Hongyuan-mees/embedded-game/MotionGolf_Stage1_v4/README.md

* WASD / 方向键由 KEYDOWN + KEYUP 自己维护状态
* 主动关闭文本输入 / IME 模式
* Pause / Restart 有鼠标按钮
* F1 = Pause / Resume
* F2 = Restart
* P / R 仍保留，但不是必须使用
* 窗口失去焦点时自动清空按键状态，防止“卡键”
* 右侧 Last event 可以确认事件系统是否正常
