Hongyuan-mees/embedded-game/motion-controller/Core\Src\stm32f1xx_hal_msp.c

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
/* Includes ------------------------------------------------------------------*/
#include "main.h"
/* External functions --------------------------------------------------------*/
/**
  * Initializes the Global MSP.
  */
void HAL_MspInit(void)
{

  __HAL_RCC_AFIO_CLK_ENABLE();
  __HAL_RCC_PWR_CLK_ENABLE();

  /* System interrupt init*/

  /** NOJTAG: JTAG-DP Disabled and SW-DP Enabled
  */
  __HAL_AFIO_REMAP_SWJ_NOJTAG();

}

/* USER CODE BEGIN 1 */

void HAL_I2C_MspInit(I2C_HandleTypeDef *hi2c)
{
  GPIO_InitTypeDef GPIO_InitStruct = {0};

  if (hi2c->Instance == I2C1)
  {
    __HAL_RCC_GPIOB_CLK_ENABLE();
    __HAL_RCC_I2C1_CLK_ENABLE();
    __HAL_AFIO_REMAP_I2C1_ENABLE();

    GPIO_InitStruct.Pin = GPIO_PIN_8 | GPIO_PIN_9;
    GPIO_InitStruct.Mode = GPIO_MODE_AF_OD;
    GPIO_InitStruct.Speed = GPIO_SPEED_FREQ_HIGH;
    HAL_GPIO_Init(GPIOB, &GPIO_InitStruct);
  }
}

void HAL_I2C_MspDeInit(I2C_HandleTypeDef *hi2c)
{
  if (hi2c->Instance == I2C1)
  {
    __HAL_RCC_I2C1_CLK_DISABLE();
    HAL_GPIO_DeInit(GPIOB, GPIO_PIN_8 | GPIO_PIN_9);
  }
}

/* USER CODE END 1 */
