Hongyuan-mees/embedded-game/(commit log)

2026-10-30 feat: add STM32 motion controller firmware
2026-10-30 fix: normalize STM32 project directory paths
2026-10-30 feat: add Motion Golf Stage 1 game
2026-11-14 feat: add verified encoder joystick and key firmware with updated setup docs
