Hongyuan-mees/embedded-game/(notices)

Notices in the files:
motion-controller/Core\Src\stm32f1xx_hal_msp.c:
Copyright (c) 2026 STMicroelectronics.
All rights reserved.
